yunbademo/yunba-smartlock/(commit log)

2016-12-26 add commands: report, buzzer
    [sketch_smartlock.ino]
2016-12-27 fix lock status read
    [sketch_smartlock.ino]
2016-12-30 buzz when get a cmd
    [sketch_smartlock.ino]
